FrancescoPietri/FluidSync/FluidSync_Presentation.pdf

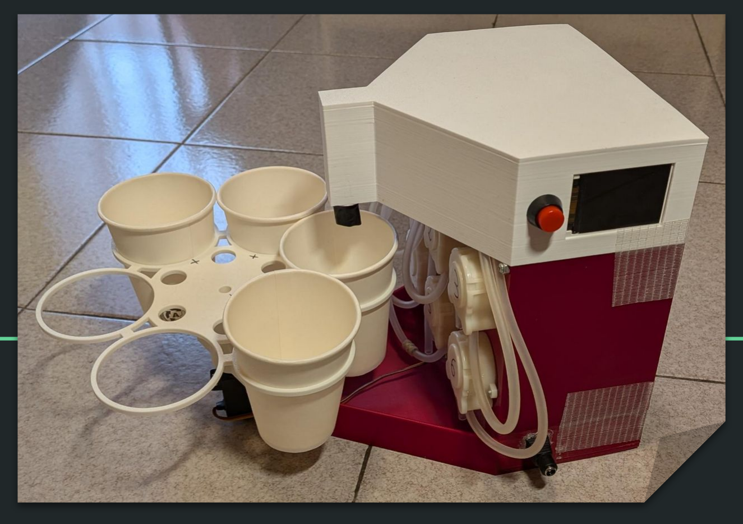
[picture p2: figure]

# FluidSync

Automatic and precise mix dispenser By Francesco Pietri

## Use Cases

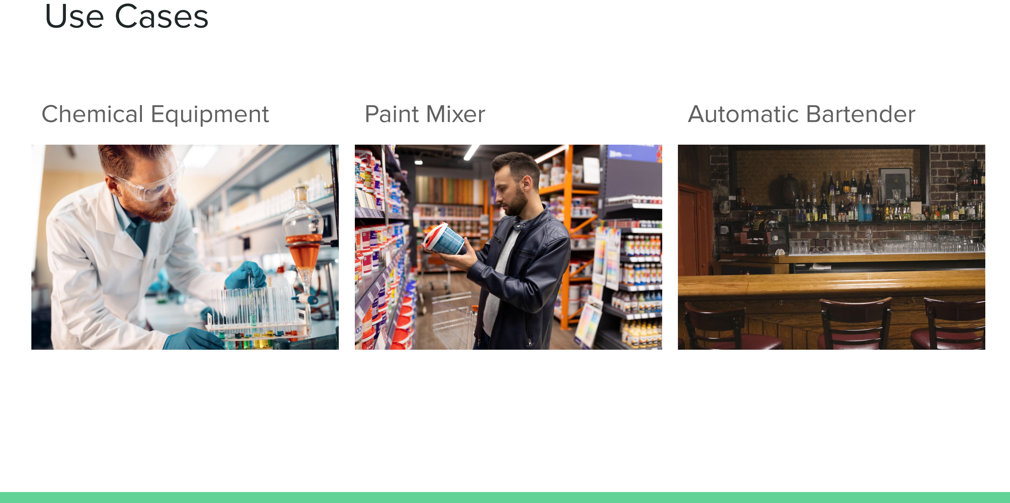
[picture p3: page 2]

Chemical Equipment | Paint Mixer | Automatic Bartender

## Hardware Components

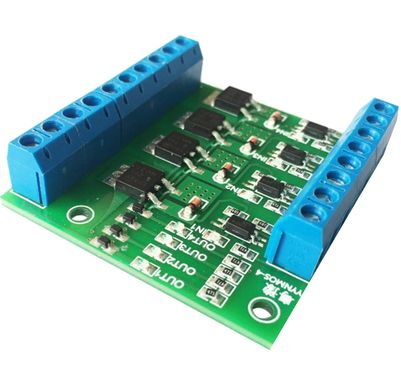
[picture p4: figure]
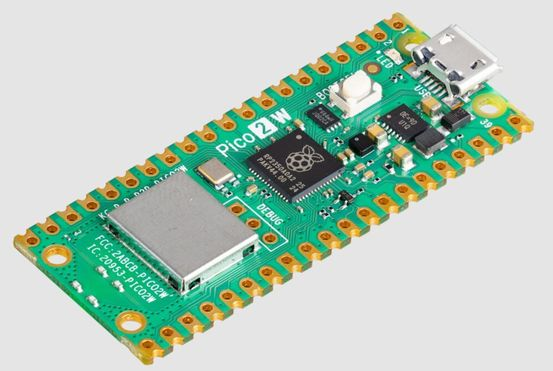
[picture p5: figure]
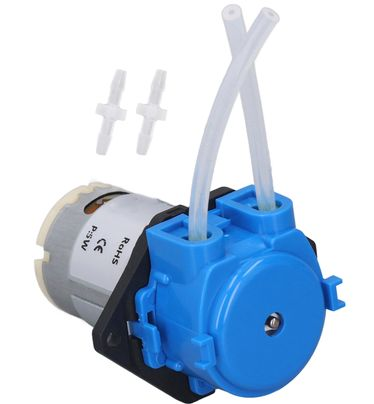
[picture p6: figure]
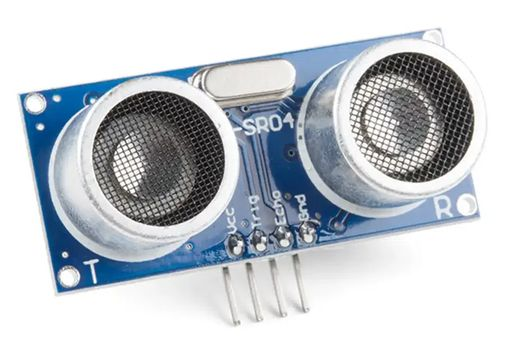
[picture p7: figure]
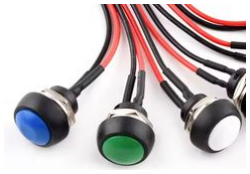
[picture p8: figure]
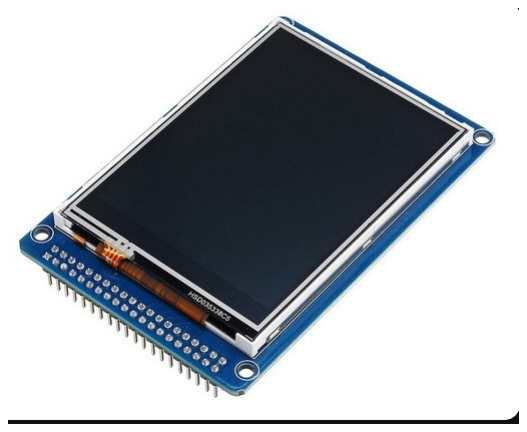
[picture p9: figure]
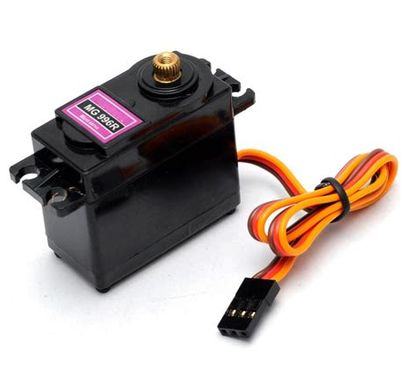
[picture p10: figure]
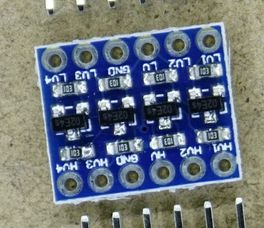
[picture p11: figure]

## Custom 3d Structure

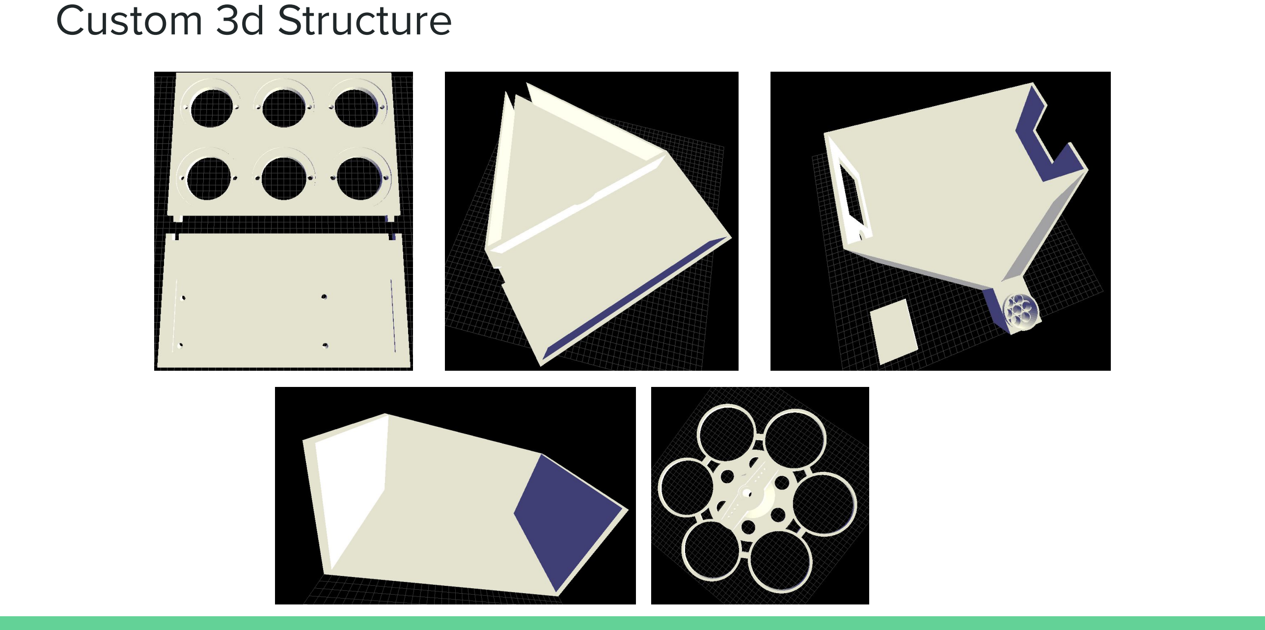
[picture p12: page 4]

## Shared Resources

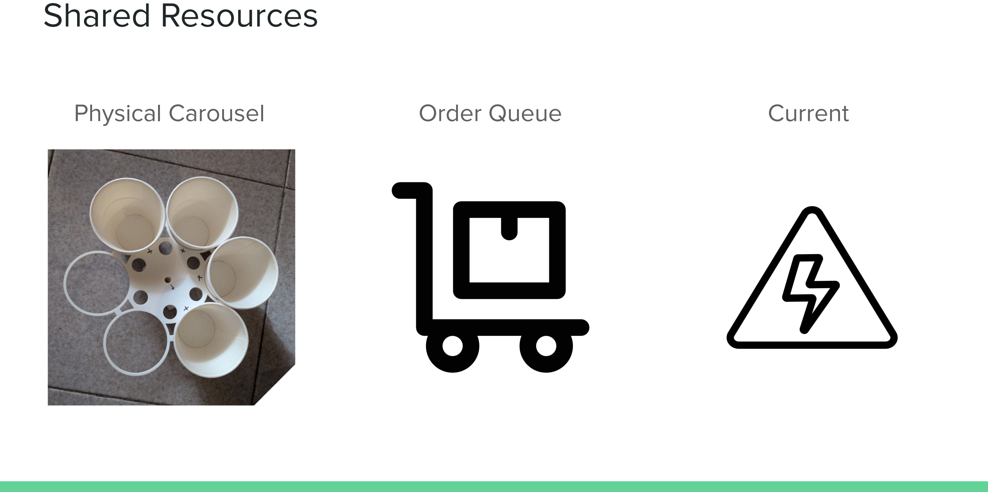
[picture p13: page 5]

Physical Carousel | Order Queue | Current

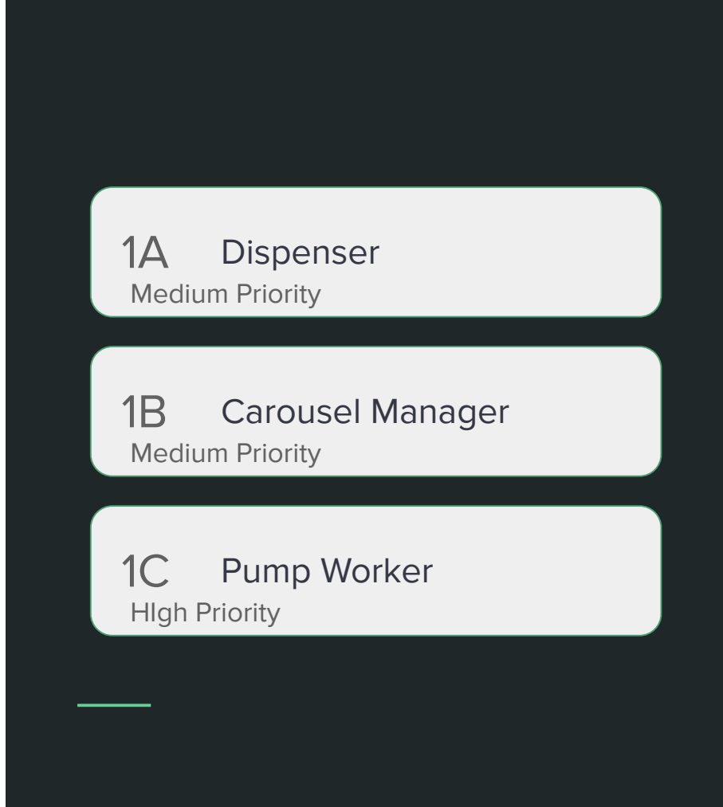
[picture p14: figure]
Dispenser; Carousel Manager; Pump Worker; Medium Priority; HIgh Priority

## Tasks

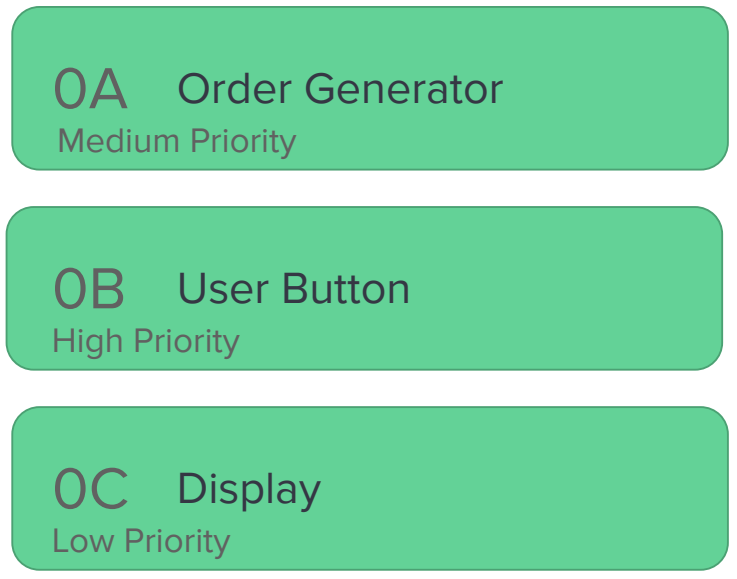
[picture p15: figure]
Order Generator; User Button; Display; Medium Priority; High Priority; Low Priority

## Mutex, Semaphores and Queue involved

order_mux

mix_done_sem

pump_queue

order_sem

## Future Development

Add a periodic error check using the ultrasonic sensor

Create an application for dynamic orders

Improve the 3D structure to make it more waterproof

# Thank you for your attention
