FrancescoPietri/FluidSync/3dStructure/FluidSync_v4_Assembly.step

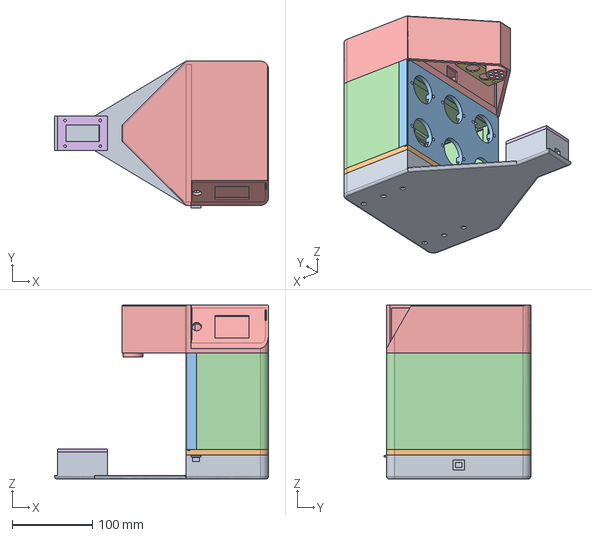
[picture p16: CAD file, 2026-11-05]
3dStructure/FluidSync_v4_Assembly.step
267.0 x 183.0 x 217.0 mm
