FrancescoPietri/FluidSync/3dStructure/FluidSync_DisplayBracket.stl

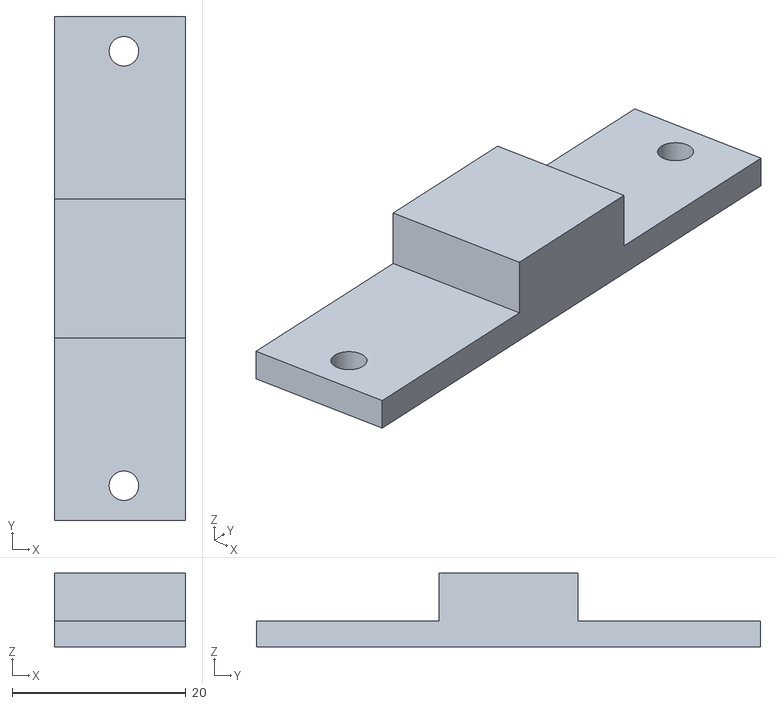
[picture p17: CAD file, 2026-11-05]
3dStructure/FluidSync_DisplayBracket.stl
15.1 x 58.0 x 8.50
