FrancescoPietri/FluidSync/3dStructure/FluidSync_FrontTray.stl

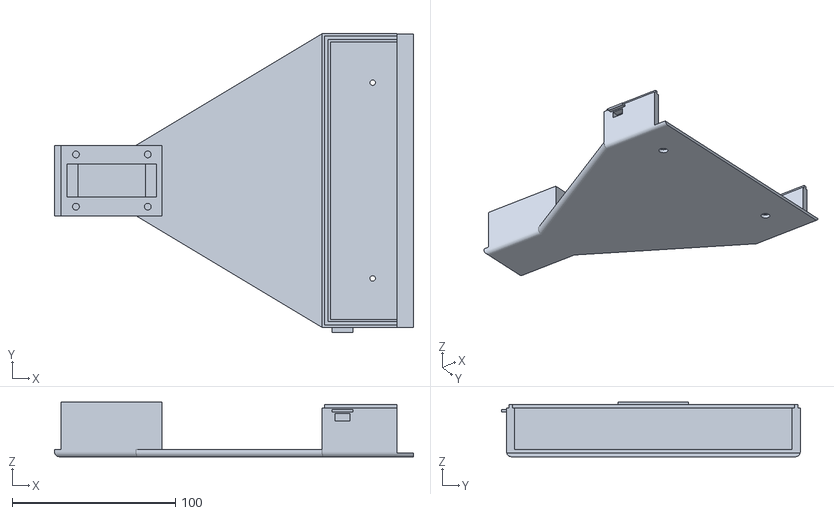
[picture p18: CAD file, 2026-11-05]
3dStructure/FluidSync_FrontTray.stl
220.0 x 183.0 x 33.5
