FrancescoPietri/FluidSync/3dStructure/FluidSync_ServoStop.stl

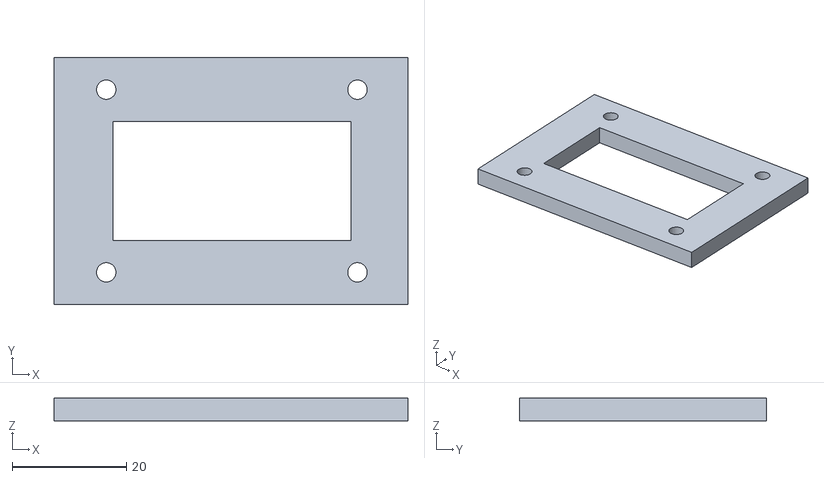
[picture p19: CAD file, 2026-11-05]
3dStructure/FluidSync_ServoStop.stl
62.0 x 43.2 x 4.00
