FrancescoPietri/FluidSync/3dStructure/FluidSync_Base.stl

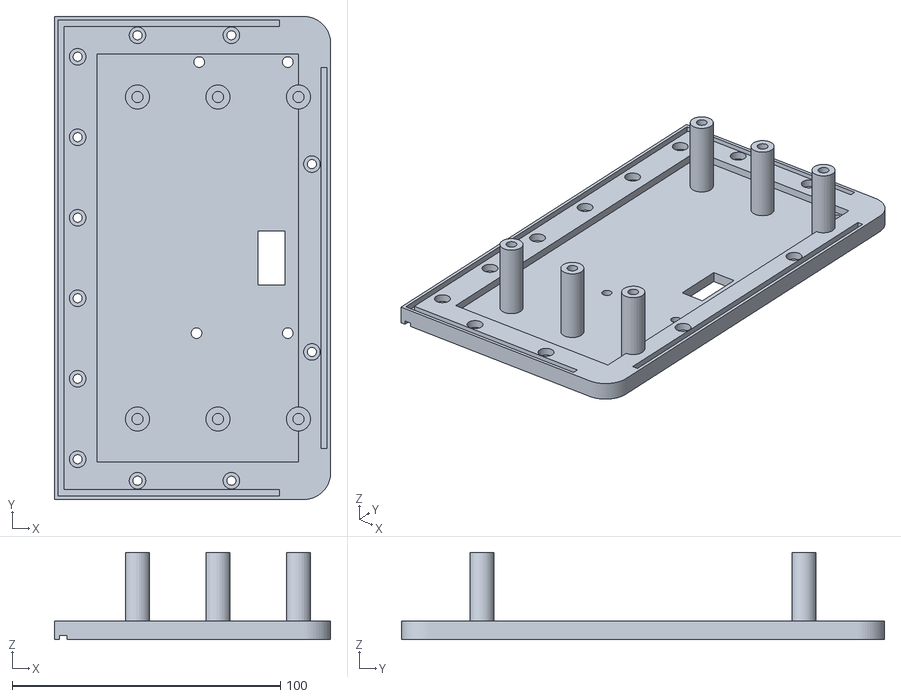
[picture p20: CAD file, 2026-11-05]
3dStructure/FluidSync_Base.stl
103.0 x 180.0 x 32.5
