FrancescoPietri/FluidSync/3dStructure/FluidSync_SensorMount.stl

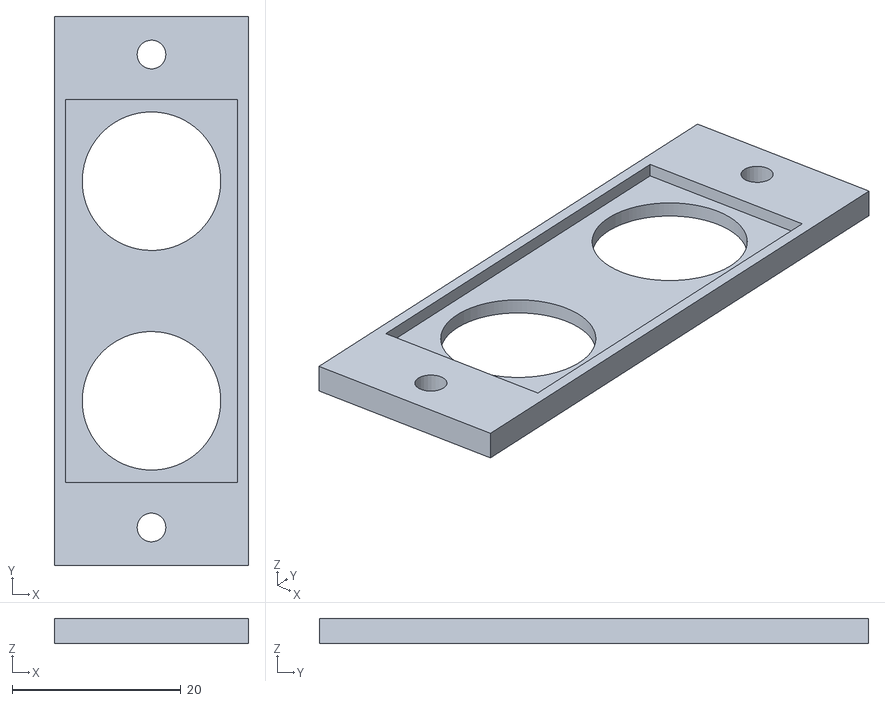
[picture p21: CAD file, 2026-11-05]
3dStructure/FluidSync_SensorMount.stl
23.0 x 65.0 x 3.00
