FrancescoPietri/FluidSync/3dStructure/FluidSync_Back.stl

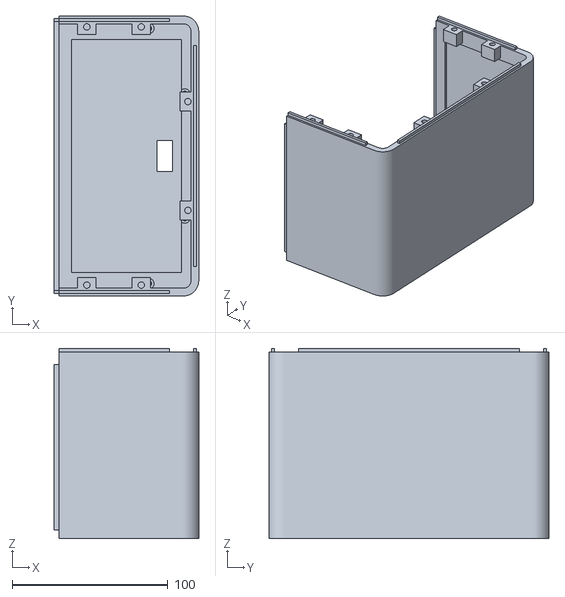
[picture p22: CAD file, 2026-11-05]
3dStructure/FluidSync_Back.stl
93.0 x 180.0 x 122.2
