FrancescoPietri/FluidSync/3dStructure/FluidSync_PumpPlate.stl

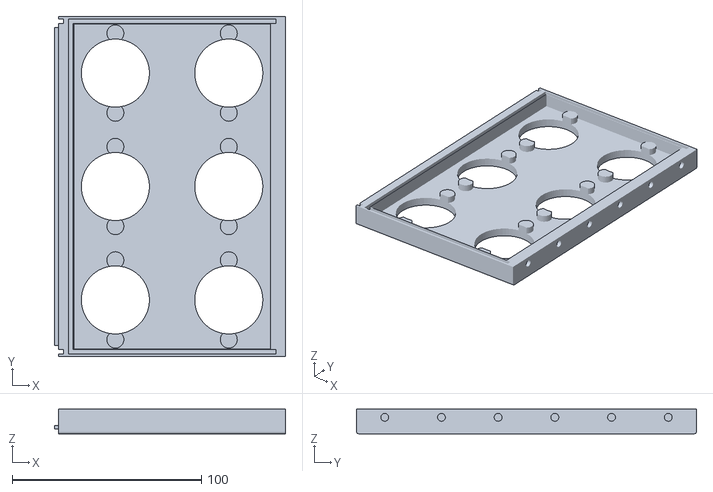
[picture p23: CAD file, 2026-11-05]
3dStructure/FluidSync_PumpPlate.stl
122.2 x 180.0 x 13.0
