FrancescoPietri/FluidSync/3dStructure/FluidSync_RearTray.stl

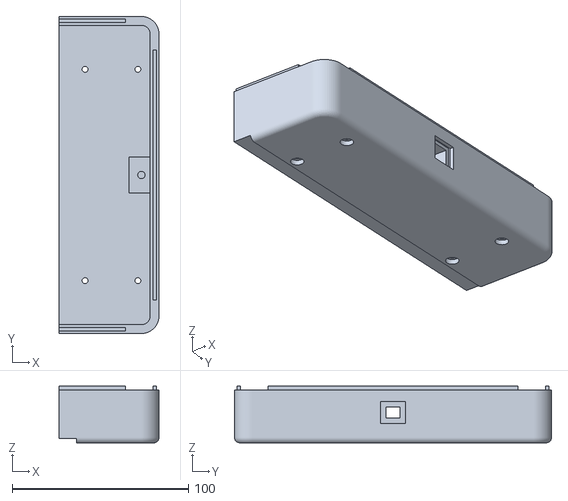
[picture p24: CAD file, 2026-11-05]
3dStructure/FluidSync_RearTray.stl
56.8 x 180.0 x 32.2
