FrancescoPietri/FluidSync/3dStructure/FluidSync_Head.stl

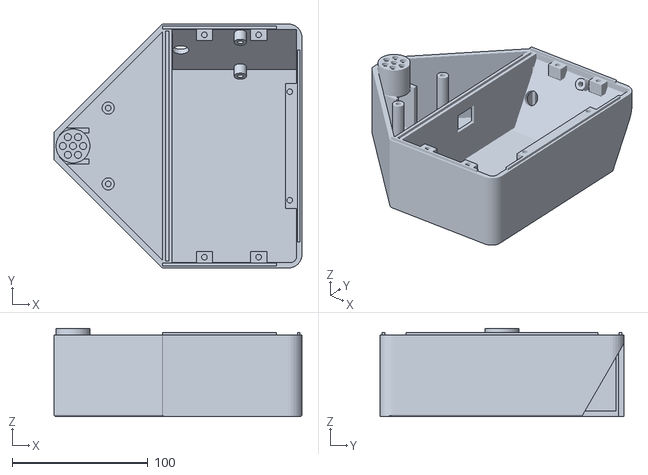
[picture p25: CAD file, 2026-11-05]
3dStructure/FluidSync_Head.stl
183.0 x 180.0 x 65.0
