FrancescoPietri/FluidSync/(commit log)

2026-06-11 Pico Setup
2026-06-19 Mapping and testing Perilstaltic pumps and Servo
    [FluidSyncPumpbox1.stl]
2026-06-26 testing sensors inits
2026-10-13 small calibration
2026-10-13 adding 3d structure files
    [FluidSyncPumpbox2.stl, FluidSyncPumpbox3.stl, FluidSyncPumpbox4.stl, FluidsyncPumpbox5.stl]
2026-11-05 implementing new 3d structure
    [FluidSyncPumpbox1.stl, FluidSyncPumpbox2.stl, FluidSyncPumpbox3.stl, FluidSyncPumpbox4.stl, FluidSync_Back.stl, FluidSync_Base.stl, FluidSync_DisplayBracket.stl, FluidSync_FrontTray.stl]
